Slenderman00/powermod-8/simulation/sim.cir

* TPS54260 DC-DC Converter Simulation
* EN PH RT PWRGD COMP VIN VSENSE BOOT SS_TR GND

.include "./tps54260_trans.lib"
.option TEMP=27C
.option interp

* Power Supply Definitions
Vpower VIN GND 60

* Nodes
X1 EN PH RT PWRGD COMP VIN VSENSE BOOT SS_TR GND TPS54260_TRANS
R7 GND RT 237k
R4 VIN EN 332k
R5 GND EN 56.2k
C9 GND COMP 33p
R8 C8 COMP 29k
C7 GND SS_TR 0.01u
C8 GND C8 4.7n
* 4.7uF x 2
C1 VIN GND 9.4u
*  47uF x 2
C5 VOUT GND 94u
L1 PH VOUT 15u
R2 VOUT VSENSE 52k
R3 VSENSE GND 11k
C3 PH BOOT 0.1u
D1 GND PH B360

* Load powersupply should be able to do 2.5 A
Rload VOUT GND 2

* B360
.model B360 D( IS=9.90n RS=14.0m BV=60.0 IBV=500u CJO=464p  M=0.333 N=0.775 TT=7.20n )

* Simulation Commands
.tran 10ns 20ms 0ms

.save VOUT
* .save VIN
* .save VSENSE
* .save PWRGD
* .save SS_TR
.save PH
* .save BOOT
* .save COMP
* .save RT
* .save EN
* .save @rload[i]
.save @L1[i]

.control
 run

 plot V(VOUT) 
* plot V(VIN) 
* plot V(VSENSE) 
* plot V(PWRGD)
* plot V(SS_TR)
 plot V(PH)
* plot V(BOOT)
* plot V(COMP)
* plot V(RT)
* plot V(EN)
* plot @rload[i]
 plot @L1[i]

 write sim.raw all

.endc

.end
