Slenderman00/powermod-8/powermod.kicad_pcb

## KiCad design powermod.kicad_pcb (2025-01-13)

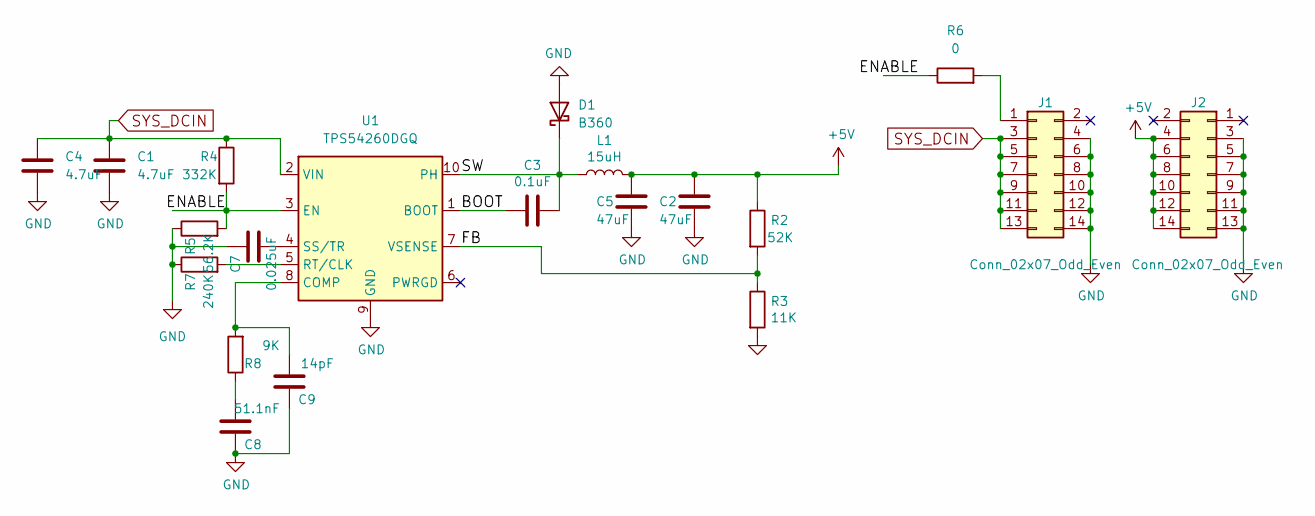
[picture p1: schematic powermod.kicad_sch, powermod-tps54260-1.4]

Parts:
C1, C4: 4.7uF; C_1210_3225Metric
C2, C5: 47uF; C_0805_2012Metric
C3: 0.1uF; C_0402_1005Metric
C7: 0.025uF; C_0402_1005Metric
C8: 51.1nF; C_0402_1005Metric
C9: 14pF; C_0402_1005Metric
D1: B360; D_SMC
J1, J2: Conn_02x07_Odd_Even; PinHeader_2x07_P2.00mm_Vertical_SMD
L1: 15uH; L_Taiyo-Yuden_MD-5050
R2: 52K; R_0402_1005Metric
R3: 11K; R_0402_1005Metric
R4: 332K; R_0402_1005Metric
R5: 56.2K; R_0402_1005Metric
R6: 0; R_0402_1005Metric
R7: 240K; R_0402_1005Metric
R8: 9K; R_0402_1005Metric
U1: TPS54260DGQ; MSOP-10-1EP_3x3mm_P0.5mm_EP2.2x3.1mm_Mask1.83x1.89mm_Therma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

Connections:
+5V: C2.1, C5.1, J2.4, J2.6, J2.8, J2.10, J2.12, J2.14, L1.2, R2.1
/BOOT: C3.2, U1.1 (BOOT)
/ENABLE: R4.2, R5.2, R6.1, U1.3 (EN)
/FB: R2.2, R3.1, U1.7 (VSENSE)
/SW: C3.1, D1.1 (K), L1.1, U1.10 (PH)
GND: C1.2, C2.2, C4.2, C5.2, C7.1, C8.1, C9.1, D1.2 (A), J1.4, J1.6, J1.8, J1.10, J1.12, J1.14, J2.3, J2.5, J2.7, J2.9, J2.11, J2.13, R3.2, R5.1, R7.1, U1.9 (GND), U1.11
unnamed: C8.2, R8.1
unnamed: J1.1, R6.2
unnamed: C9.2, R8.2, U1.8 (COMP)
unnamed: R7.2, U1.5 (RT/CLK)
unnamed: C7.2, U1.4 (SS/TR)
SYS_DCIN: C1.1, C4.1, J1.3, J1.5, J1.7, J1.9, J1.11, J1.13, R4.1, U1.2 (VIN)

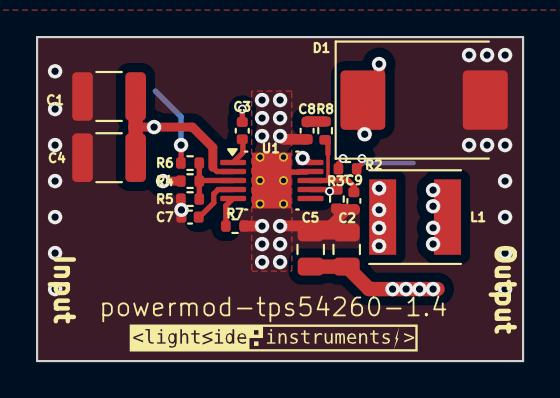
[picture p2: board powermod.kicad_pcb from above]

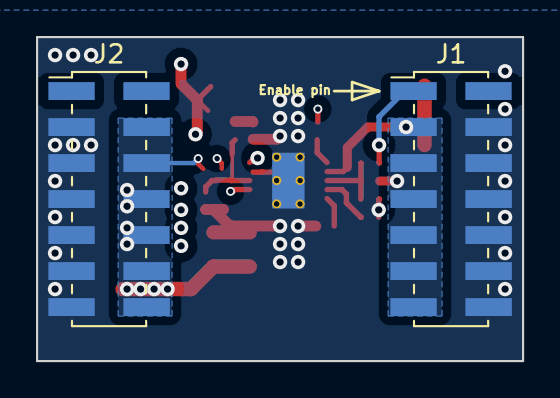
[picture p3: board powermod.kicad_pcb from below]

Board: 4 copper layers, 27.0 x 18.0 mm, 21 parts (2 on the bottom side), 12 nets.

Other parts of the board:
svg2mod: G***; lsi-logo-16mm
