Slenderman00/powermod-8/(commit log)

2024-10-14 fix: simulating bom values
2024-10-17 feat: shorter and more shielded signal paths
    [powermod.kicad_pcb]
2024-10-17 feat: shorter paths
    [powermod.kicad_pcb]
2024-10-17 fix: removed stray trace
    [powermod.kicad_pcb]
2024-10-17 fix: added missing traces
    [powermod.kicad_pcb]
2024-10-17 feat: reduced crosstalk between sw and comp
    [powermod.kicad_pcb]
2024-10-17 feat: reduced crosstalk between sw and +5v
    [powermod.kicad_pcb]
2024-11-04 feat: moved feedback resistor
    [powermod.kicad_pcb]
2024-11-04 fix: added missing trace
    [powermod.kicad_pcb]
2024-11-04 fix: moved vias
    [powermod.kicad_pcb]
2025-01-13 fix: updated the version
    [powermod.kicad_pcb]
2025-01-13 feat: 1.4
    [powermod.kicad_pcb, powermod.kicad_sch]
2025-01-23 feat: new cpl
    [cpl.csv]
